MuhammadIsmail0331/mclaren-6wd-sumobot/cad/rev-d-workshop/README.md

# Rev D workshop fit prototype

This is the preserved workshop revision. The 180-instance SolidWorks 2025 assembly shows six adapted holders and retains the 12 earlier saddle/cap instances hidden. It contains the wider motor rail returns and was tested by rebuilding a copy extracted into a separate folder.

- [Workshop handoff](START%20HERE.md)
- [Hardware and fit checks](Hardware%20to%20buy.md)
- [Native verification](Native%20verification.json)
- [SolidWorks files](SolidWorks)
- [Print-first files](Print%20-%20first%20fit%20only)
- [Pilot laser profiles](Laser%20-%20pilot%20files)

The pilot profiles support a first build trial. Confirm the gearbox and tire fit and shop forming and joining before cutting a complete chassis. The lower-cost club build is tracked separately.
