MuhammadIsmail0331/mclaren-6wd-sumobot/cad/rev-c/Views/02 Gearmotor face rail.png

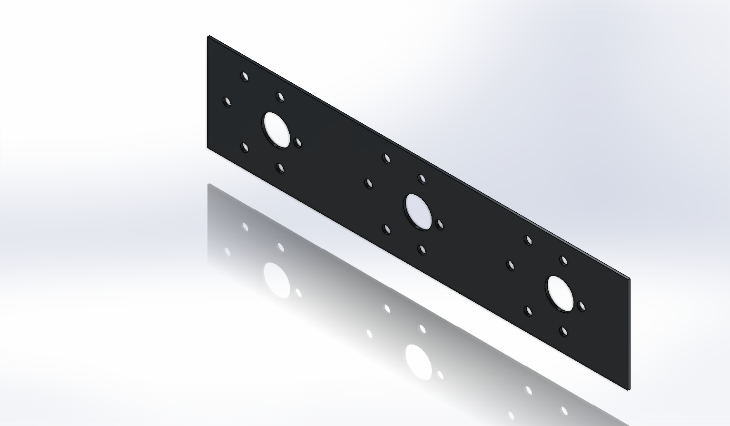
cad/rev-c/Views/02 Gearmotor face rail.png
