MuhammadIsmail0331/mclaren-6wd-sumobot/cad/rev-c/Views/04 PETG motor clamp saddle.png

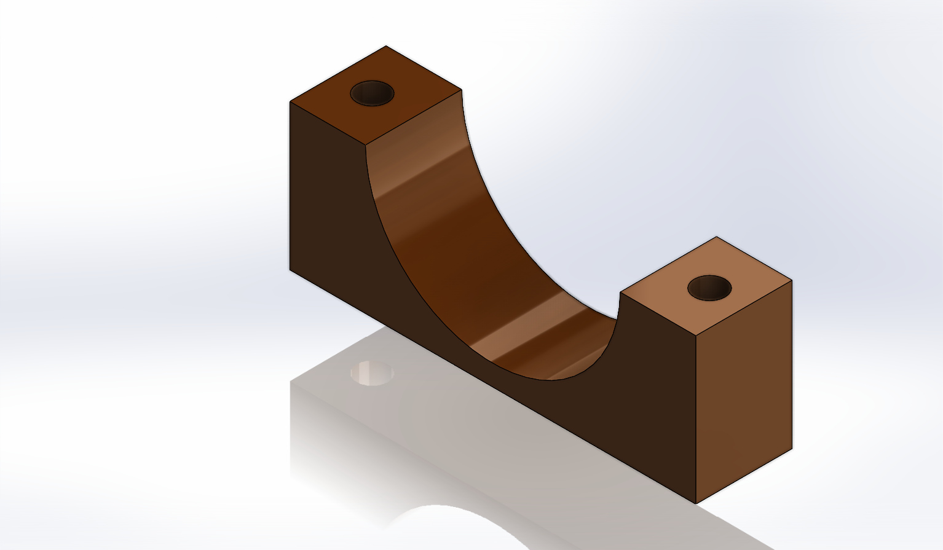
cad/rev-c/Views/04 PETG motor clamp saddle.png
