MuhammadIsmail0331/mclaren-6wd-sumobot/cad/rev-c/Views/05 PETG motor clamp cap.png

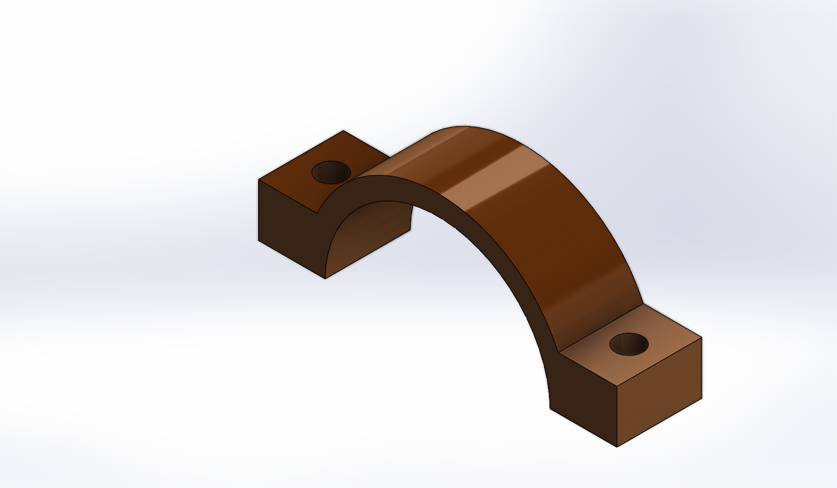
cad/rev-c/Views/05 PETG motor clamp cap.png
