MuhammadIsmail0331/mclaren-6wd-sumobot/cad/rev-c/Views/12 Insulated pack tray.png

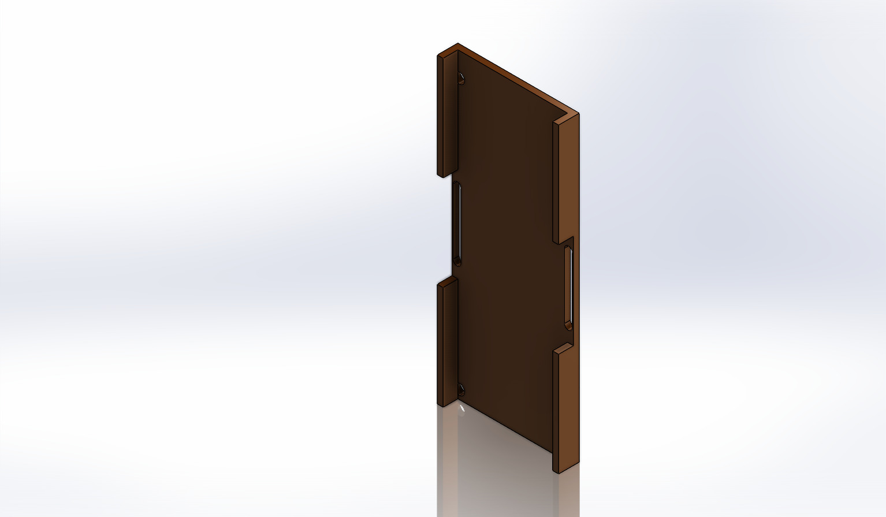
cad/rev-c/Views/12 Insulated pack tray.png
