MuhammadIsmail0331/mclaren-6wd-sumobot/cad/rev-c/Views/15 Electronics deck.png

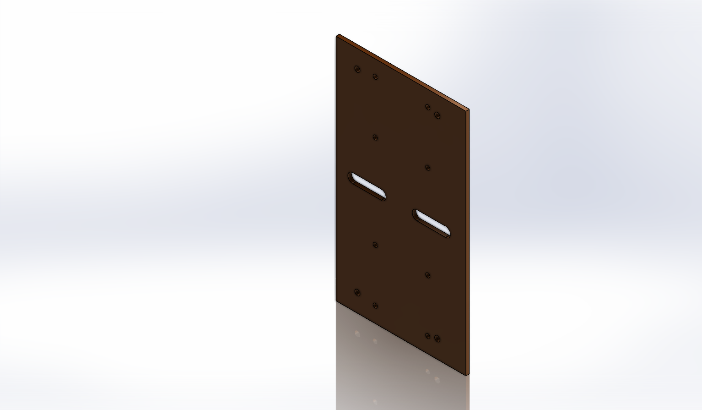
cad/rev-c/Views/15 Electronics deck.png
