MuhammadIsmail0331/mclaren-6wd-sumobot/cad/rev-c/Views/18 Electronics side riser.png

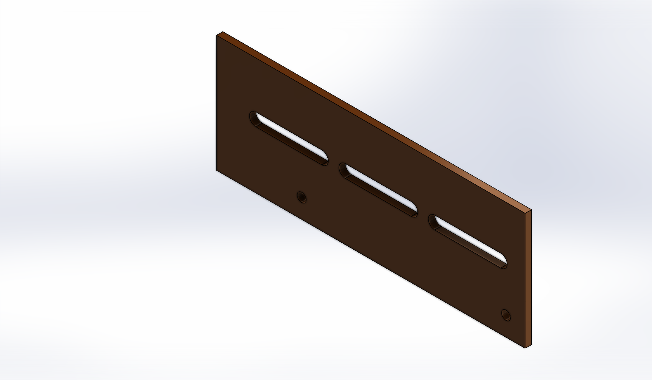
cad/rev-c/Views/18 Electronics side riser.png
