MuhammadIsmail0331/mclaren-6wd-sumobot/cad/rev-c/Views/23 Gearbox face doubler.png

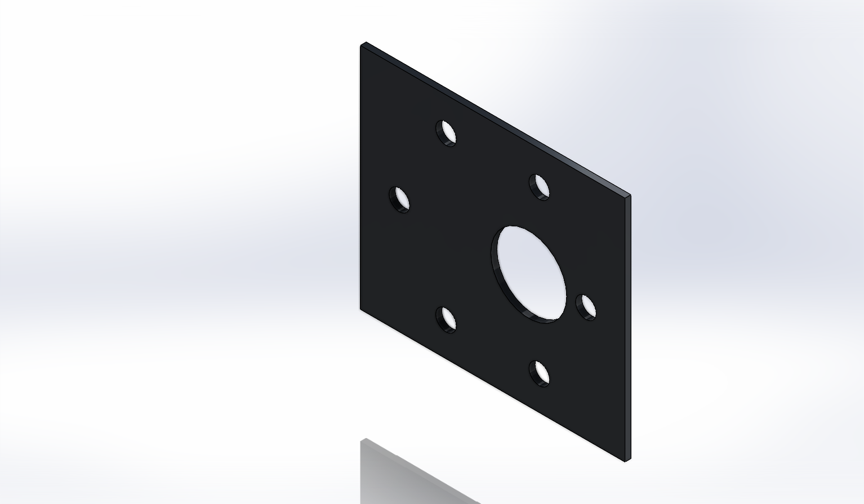
cad/rev-c/Views/23 Gearbox face doubler.png
