MuhammadIsmail0331/mclaren-6wd-sumobot/cad/rev-c/Views/REF Team JGB37 motor.png

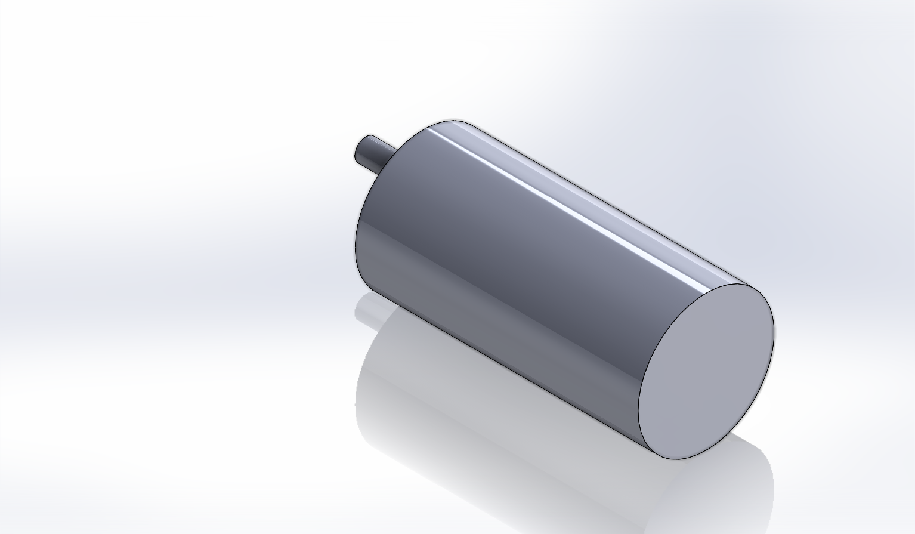
cad/rev-c/Views/REF Team JGB37 motor.png
