MuhammadIsmail0331/mclaren-6wd-sumobot/cad/rev-c/Views/RevC CAD 02 Plan.png

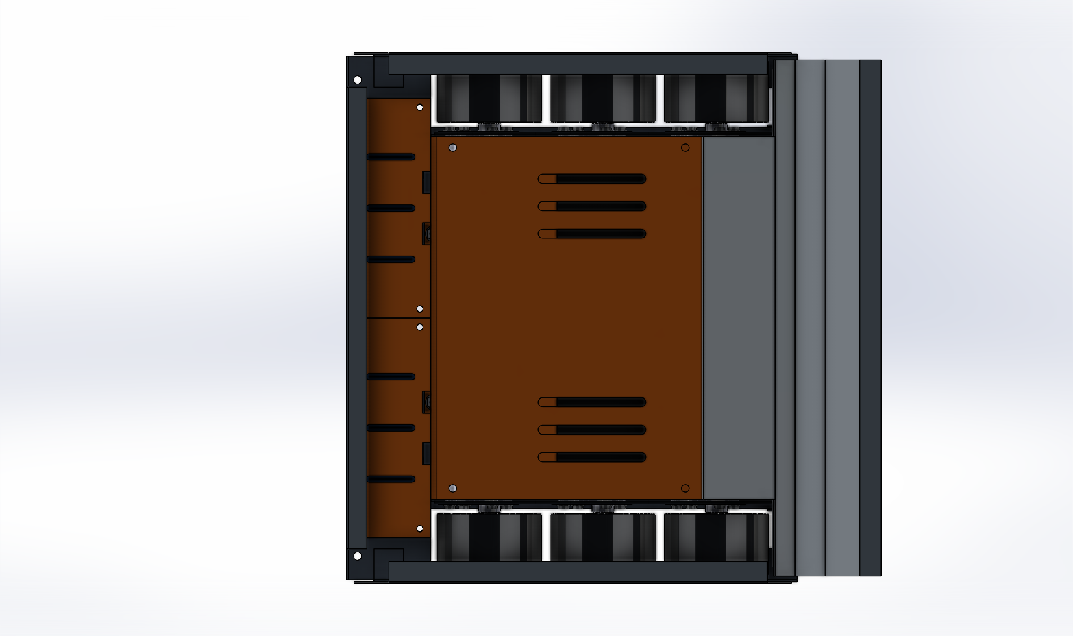
cad/rev-c/Views/RevC CAD 02 Plan.png
