MuhammadIsmail0331/mclaren-6wd-sumobot/cad/rev-c/Views/RevC CAD 03 Side.png

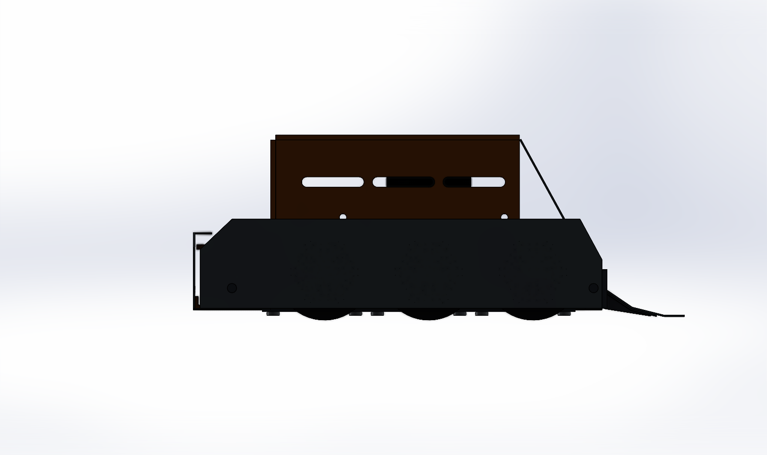
cad/rev-c/Views/RevC CAD 03 Side.png
