MuhammadIsmail0331/mclaren-6wd-sumobot/cad/rev-c/Views/RevC CAD 04 Front.png

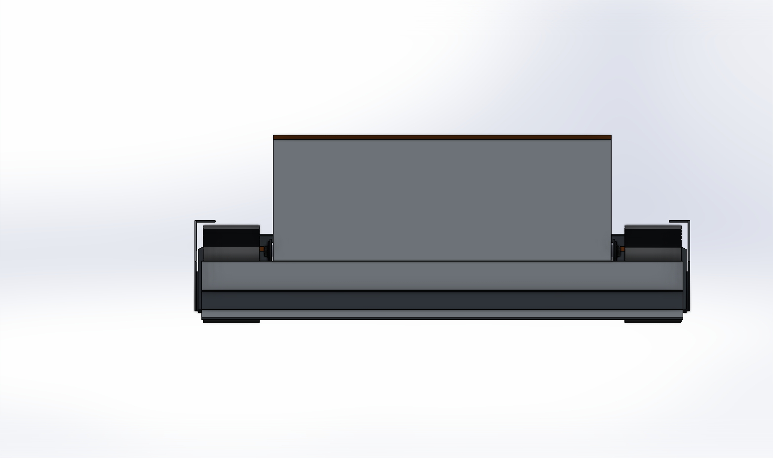
cad/rev-c/Views/RevC CAD 04 Front.png
