MuhammadIsmail0331/mclaren-6wd-sumobot/cad/rev-c/Views/RevC CAD 05 Service access.png

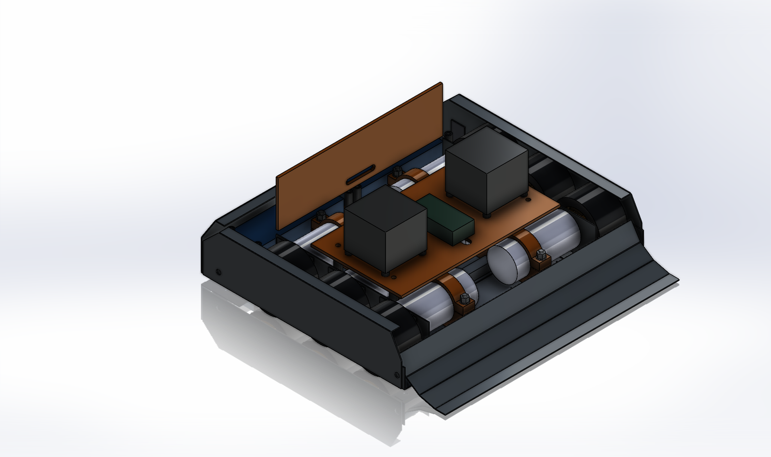
cad/rev-c/Views/RevC CAD 05 Service access.png
