MuhammadIsmail0331/mclaren-6wd-sumobot/cad/rev-c/Views/RevC CAD 06 Drivetrain and packs.png

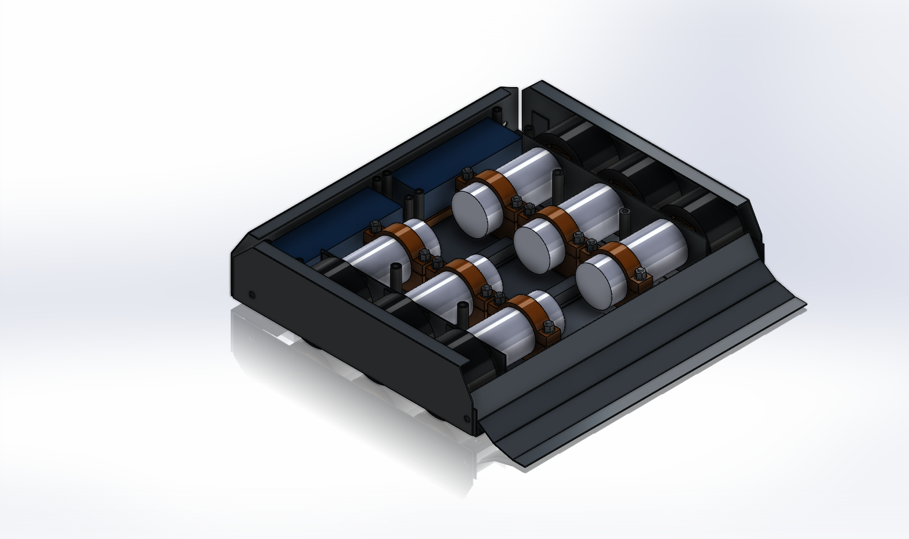
cad/rev-c/Views/RevC CAD 06 Drivetrain and packs.png
