MuhammadIsmail0331/mclaren-6wd-sumobot/cad/rev-c/Views/RevC CAD 07 Motor mounting bank.png

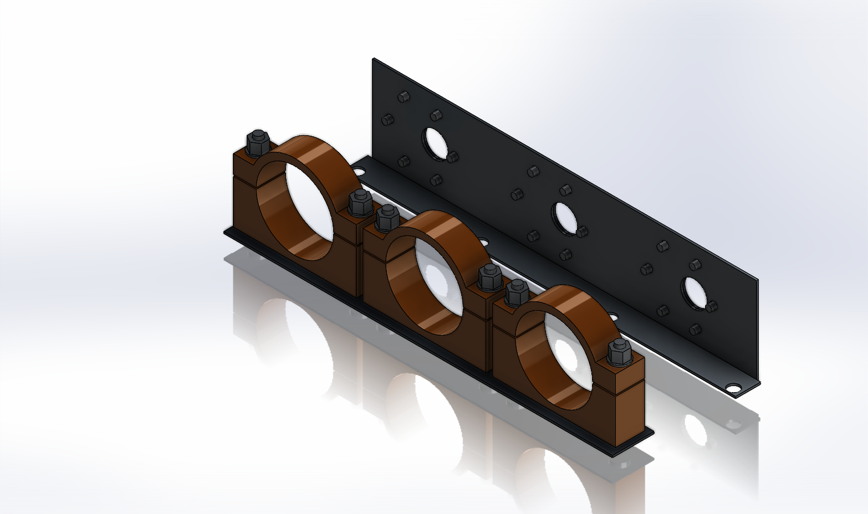
cad/rev-c/Views/RevC CAD 07 Motor mounting bank.png
