MuhammadIsmail0331/mclaren-6wd-sumobot/cad/rev-a/Parts list.md

# McLaren 6WD Rev A parts list

| Native part | Quantity | Material or fit status |
|---|---:|---|
| 01 Base plate | 1 | 2 mm low-carbon steel, laser cut |
| 02 Gearmotor face rail | 2 | 3 mm low-carbon steel, transfer drill gearbox screws |
| 03 Motor rail weld-on flange | 2 | 3 mm low-carbon steel, weld to rail then bolt to floor |
| 04 Rear motor cradle | 6 | PETG saddle plus thin compliant anti-slip strip, under body only |
| 05 Motor keeper strap envelope | 6 | Cushioned metal band with feet. Detail after motor fit. |
| 06 Formed three-bend scoop | 1 | 1.5 mm low-carbon steel, 2 mm provisional inside radius |
| 07 Scoop support rib | 3 | 3 mm low-carbon steel, profile cut |
| 08 Scoop support foot | 3 | 3 mm steel, weld under each rib |
| 09 Wheel side guard | 2 | 2 mm low-carbon steel, removable |
| 10 Guard angle | 4 | 2 mm steel, welded L or press-brake angle |
| 11 Rear bumper wall | 1 | 2 mm low-carbon steel |
| 12 Insulated pack tray | 2 | PETG, 41 x 108 mm print; add compliant liner and strap |
| 13 Pack access panel | 2 | PETG, removable insulated cover |
| 14 Pack panel spacer | 8 | Nylon or PETG prototype spacer |
| 15 Electronics deck | 1 | PETG, insulated removable deck, 109 x 196 mm |
| 16 Deck spacer | 4 | Insulated M4 spacer, sleeve or standoff |
| 17 PCB insulating standoff | 8 | Nylon, location subject to PCB hole measurement |
| 18 Electronics side riser | 2 | PETG, behind tire envelope |
| 19 Front upper closure | 1 | 2 mm low-carbon steel, or bendable abrasion-resistant polymer |
| 20 Electronics lid | 1 | PETG, 145 x 198 mm, vented and removable |
| 21 Electronics rear closure | 1 | PETG, center cable pass |
| 22 Silicone tread envelope | 6 | Cast silicone, 57 OD x 33 mm. Actual casting fills around rim. |
| REF ESP32 plus buck space | 1 | Provisional 54 x 26 x 15 mm logic space |
| REF LiPo 3S pack envelope | 2 | Provisional 35 x 100 x 27 mm. Confirm each pack and lead exit. |
| REF Team IBT-2 | 2 | Team October module envelope. Verify mounting and terminal access. |
| REF Team JGB37 motor | 6 | Team October motor envelope. Verify screw pattern and wire/terminal reach. |
| REF Team rim 0.22 | 6 | Team November rim STEP. Verify shaft fit with a sample casting. |

Total modeled instances **84**. Add measured fasteners, pack straps, compliant liners, wiring, protection and disconnect hardware for fabrication.
