MuhammadIsmail0331/mclaren-6wd-sumobot/cad/rev-c/Mount laser DXF/03 Motor rail return strip.dxf

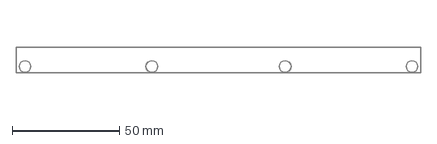
[picture p17: CAD file, 2026-11-09]
cad/rev-c/Mount laser DXF/03 Motor rail return strip.dxf
188.0 x 12.0 mm
