MuhammadIsmail0331/mclaren-6wd-sumobot/cad/rev-c/Mount STEP/23 Gearbox face doubler.STEP

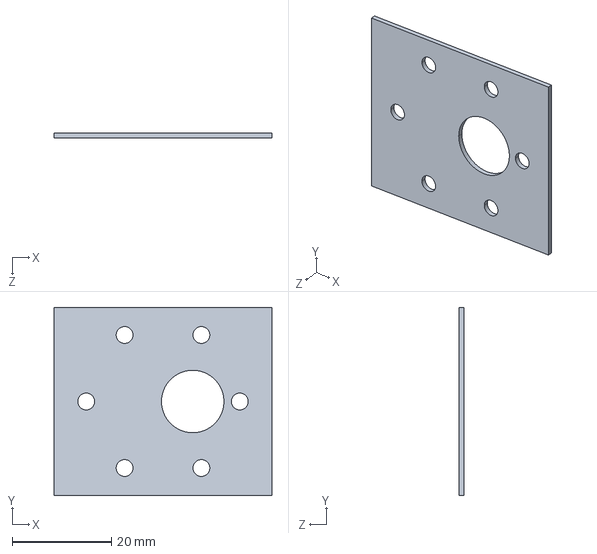
[picture p18: CAD file, 2026-11-09]
cad/rev-c/Mount STEP/23 Gearbox face doubler.STEP
44.0 x 38.0 x 1.00 mm
