MuhammadIsmail0331/mclaren-6wd-sumobot/cad/rev-c/Reference STEP/Motors.STEP

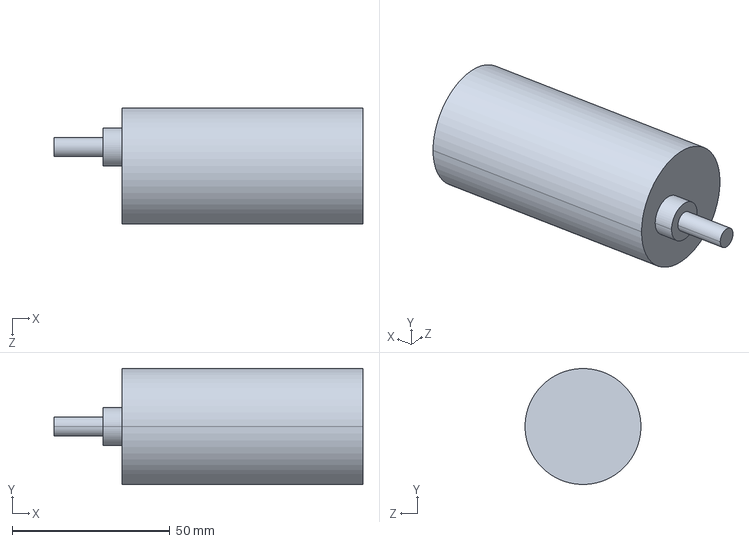
[picture p19: CAD file, 2026-11-06]
cad/rev-c/Reference STEP/Motors.STEP
98.0 x 36.8 x 36.8 mm
