MuhammadIsmail0331/mclaren-6wd-sumobot/cad/rev-d-workshop/Laser - pilot files/23 Gearbox face doubler - transfer drill.dxf

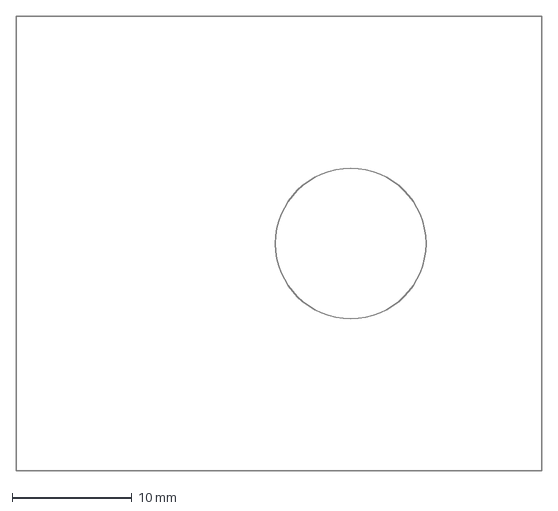
[picture p20: CAD file, 2026-11-09]
cad/rev-d-workshop/Laser - pilot files/23 Gearbox face doubler - transfer drill.dxf
44.0 x 38.0 mm
