MuhammadIsmail0331/mclaren-6wd-sumobot/cad/rev-d-workshop/McLaren 6WD - Rev D fit.STEP

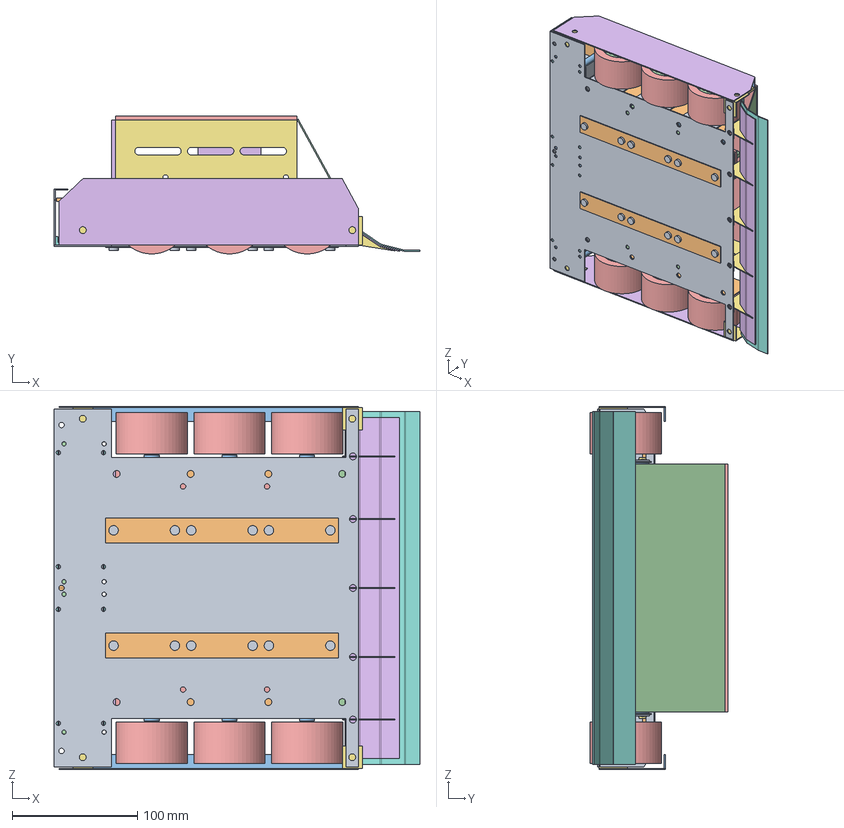
[picture p21: CAD file, 2026-11-09]
cad/rev-d-workshop/McLaren 6WD - Rev D fit.STEP
292.0 x 110.0 x 290.0 mm
01 Base plate
02 Gearmotor face rail x 2
REF Team JGB37 motor x 6
REF Team rim 0.22 x 6
22 Silicone tread envelope x 6
09 Wheel side guard x 2
10 Guard angle x 4
12 Insulated pack tray x 2
REF LiPo 3S pack envelope x 2
13 Pack access panel x 2
14 Purchased M3 pack-cover spacer x 8
16 Purchased M4 deck spacer x 4
17 Purchased M3 PCB spacer x 8
REF Team IBT-2 x 2
18 Electronics side riser x 2
06 Three-bend scoop skin
11 Rear bumper wall
15 Electronics deck
REF ESP32 plus buck space
19 Front upper closure
20 Electronics lid
21 Electronics rear closure
07 Scoop support rib x 5
08 Scoop support foot x 5
23 Gearbox face doubler x 6
24 Clamp backing strip x 2
27 Side guard inboard return x 2
28 Rear bumper return
25 Floor hat stiffener x 2
26 Scoop formed underlay
29 REF M3x5 face screw and washer x 36
03 Wide motor rail return x 2
33 REF M4x20 low-head floor bolt x 12
31 REF M4 washer and locknut - floor x 12
34 REF M4x20 jaw bolt and 2 mm spacer x 6
35 REF M4 narrow washer and locknut x 6
32 Shaheer V2 holder - chassis fit x 6
