MuhammadIsmail0331/mclaren-6wd-sumobot/cad/rev-d-workshop/Print - after fit/18 Electronics side riser.STL

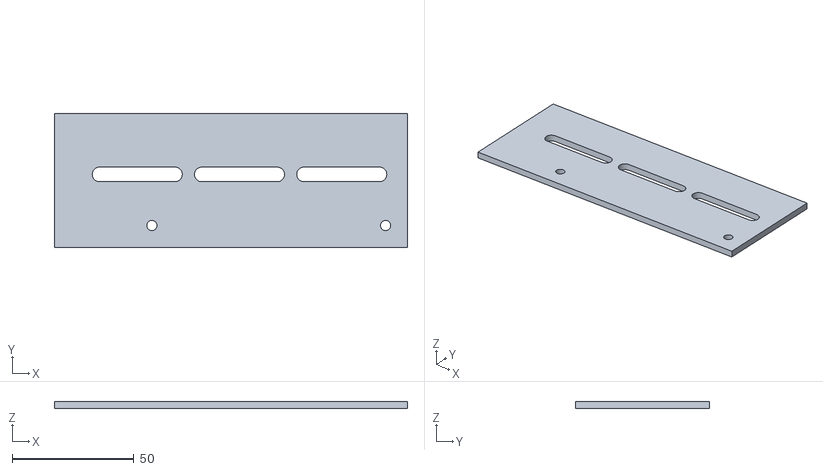
[picture p22: CAD file, 2026-11-09]
cad/rev-d-workshop/Print - after fit/18 Electronics side riser.STL
145.0 x 55.0 x 3.00
