MuhammadIsmail0331/mclaren-6wd-sumobot/cad/rev-d-workshop/Print - first fit only/01 PRINT ONE - 32 Shaheer V2 holder - chassis fit.stl

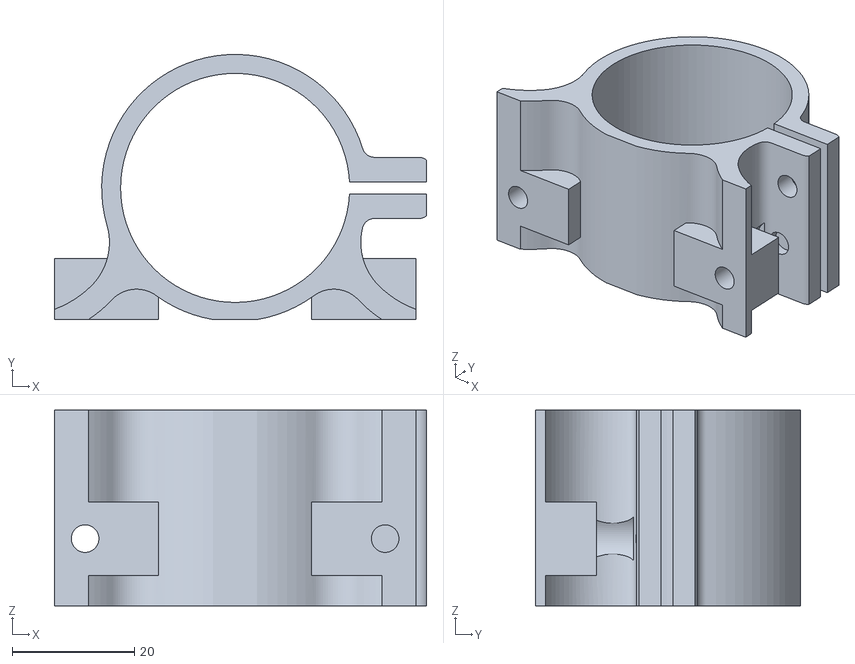
[picture p23: CAD file, 2026-11-09]
cad/rev-d-workshop/Print - first fit only/01 PRINT ONE - 32 Shaheer V2 holder - chassis fit.stl
60.8 x 43.3 x 32.0
