MuhammadIsmail0331/mclaren-6wd-sumobot/cad/rev-c/Mount laser DXF/02 Gearmotor face rail.dxf

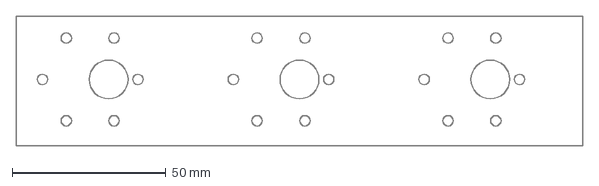
[picture p24: CAD file, 2026-11-09]
cad/rev-c/Mount laser DXF/02 Gearmotor face rail.dxf
184.0 x 42.0 mm
