MuhammadIsmail0331/mclaren-6wd-sumobot/cad/rev-c/Reference STEP/wheels sumo 0.22 tol.step

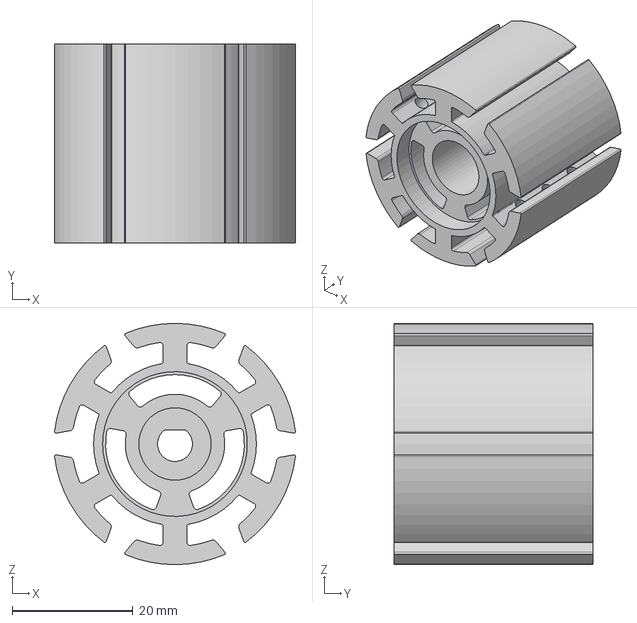
[picture p25: CAD file, 2026-11-06]
cad/rev-c/Reference STEP/wheels sumo 0.22 tol.step
40.0 x 33.0 x 40.0 mm
