MuhammadIsmail0331/mclaren-6wd-sumobot/cad/rev-d-workshop/Laser - pilot files/02 Gearmotor face rail - transfer drill.dxf

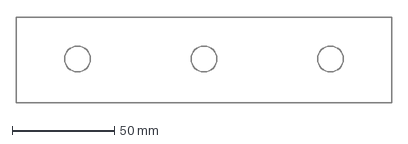
[picture p26: CAD file, 2026-11-09]
cad/rev-d-workshop/Laser - pilot files/02 Gearmotor face rail - transfer drill.dxf
184.0 x 42.0 mm
