MuhammadIsmail0331/mclaren-6wd-sumobot/cad/rev-d-workshop/Print - after fit/13 Pack access panel.STL

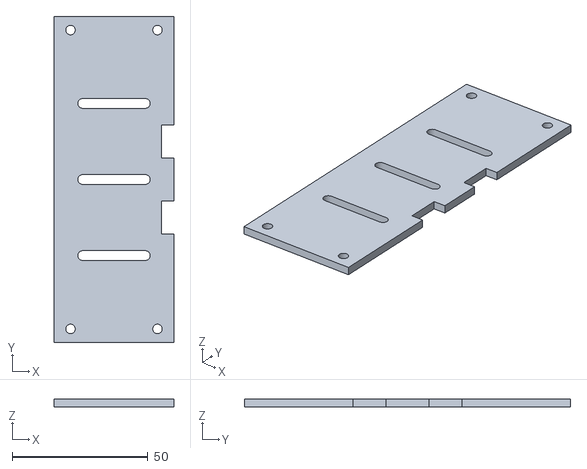
[picture p27: CAD file, 2026-11-09]
cad/rev-d-workshop/Print - after fit/13 Pack access panel.STL
44.0 x 120.0 x 2.80
