MuhammadIsmail0331/mclaren-6wd-sumobot/cad/rev-d-workshop/Print - first fit only/02 GAUGE BATTERY FIRST - 12 Insulated pack tray.STL

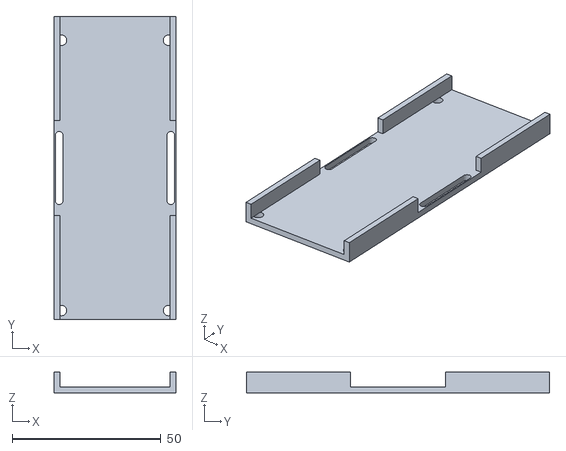
[picture p28: CAD file, 2026-11-09]
cad/rev-d-workshop/Print - first fit only/02 GAUGE BATTERY FIRST - 12 Insulated pack tray.STL
41.0 x 102.0 x 7.00
