MuhammadIsmail0331/mclaren-6wd-sumobot/cad/rev-d-workshop/SolidWorks/14 Purchased M3 pack-cover spacer.SLDPRT

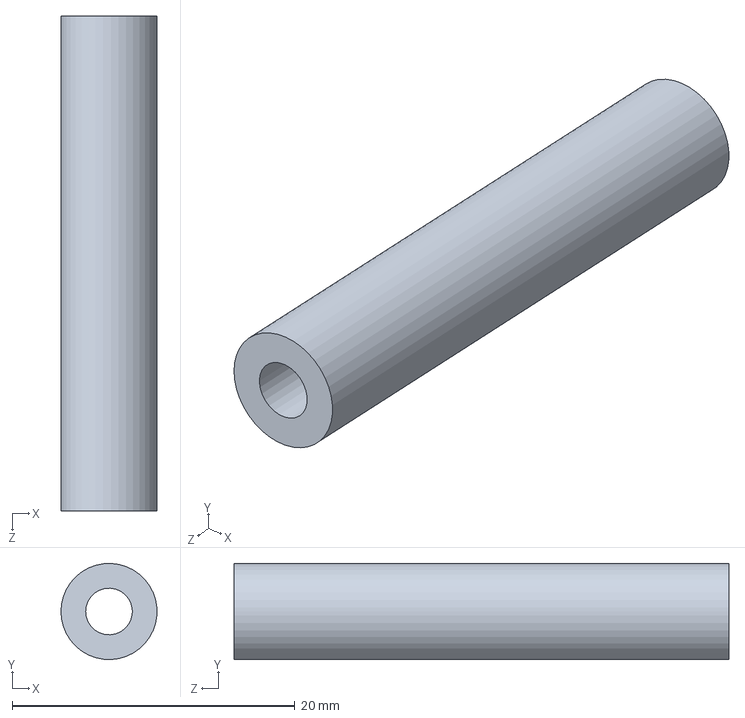
[picture p29: CAD file, 2026-11-09]
cad/rev-d-workshop/SolidWorks/14 Purchased M3 pack-cover spacer.SLDPRT
6.80 x 6.79 x 35.0 mm
