MuhammadIsmail0331/mclaren-6wd-sumobot/cad/rev-c/03 Motor rail return strip.SLDPRT

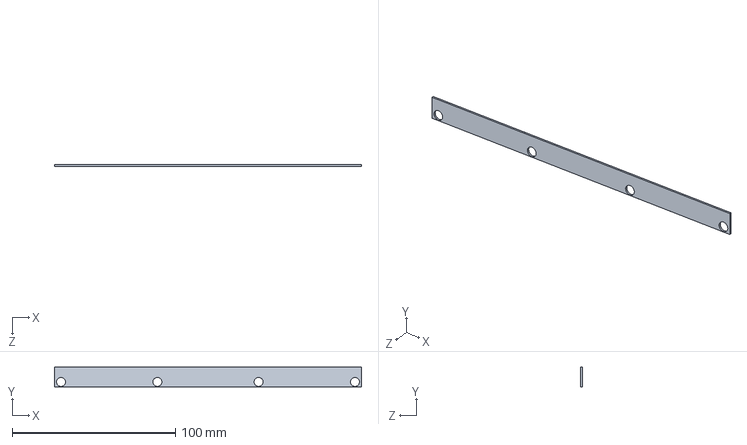
[picture p30: CAD file, 2026-11-09]
cad/rev-c/03 Motor rail return strip.SLDPRT
188.0 x 12.0 x 1.00 mm
