MuhammadIsmail0331/mclaren-6wd-sumobot/cad/rev-c/Mount laser DXF/23 Gearbox face doubler.dxf

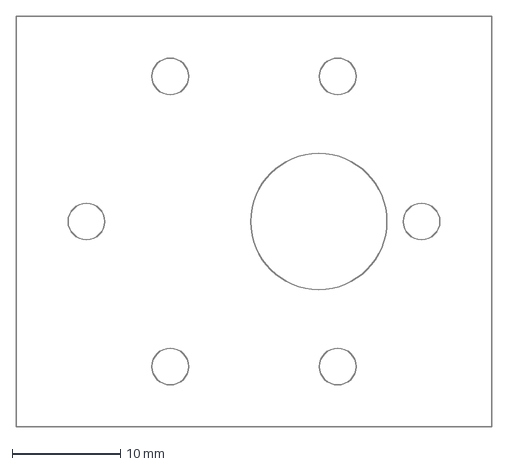
[picture p31: CAD file, 2026-11-09]
cad/rev-c/Mount laser DXF/23 Gearbox face doubler.dxf
44.0 x 38.0 mm
