MuhammadIsmail0331/mclaren-6wd-sumobot/cad/rev-c/Reference STEP/Motor Driver.STEP

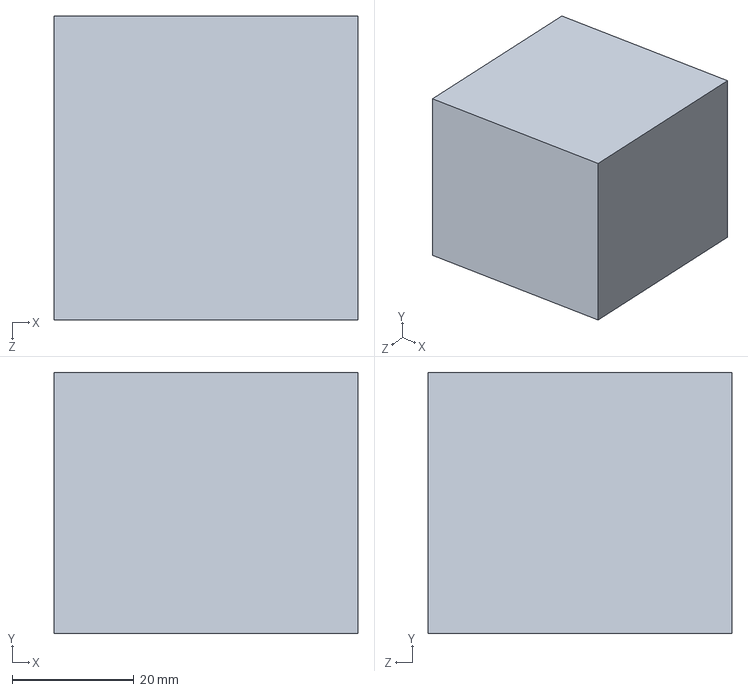
[picture p32: CAD file, 2026-11-06]
cad/rev-c/Reference STEP/Motor Driver.STEP
50.0 x 43.0 x 50.0 mm
