MuhammadIsmail0331/mclaren-6wd-sumobot/cad/rev-d-workshop/Laser - pilot files/03 Wide motor rail return - shop review.dxf

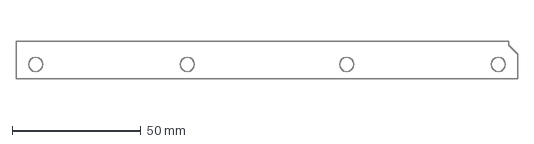
[picture p33: CAD file, 2026-11-09]
cad/rev-d-workshop/Laser - pilot files/03 Wide motor rail return - shop review.dxf
195.0 x 14.5 mm
