MuhammadIsmail0331/mclaren-6wd-sumobot/cad/rev-d-workshop/Print - first fit only/03 GAUGE BOARDS FIRST - 15 Electronics deck.STL

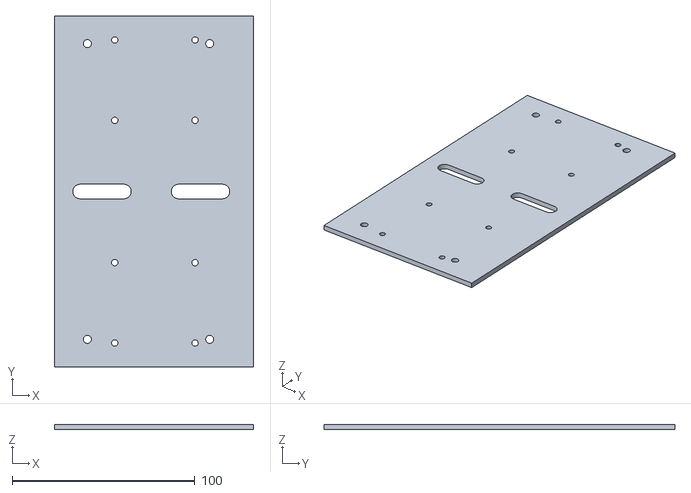
[picture p34: CAD file, 2026-11-09]
cad/rev-d-workshop/Print - first fit only/03 GAUGE BOARDS FIRST - 15 Electronics deck.STL
109.0 x 192.0 x 3.00
