MuhammadIsmail0331/mclaren-6wd-sumobot/cad/rev-d-workshop/SolidWorks/17 Purchased M3 PCB spacer.SLDPRT

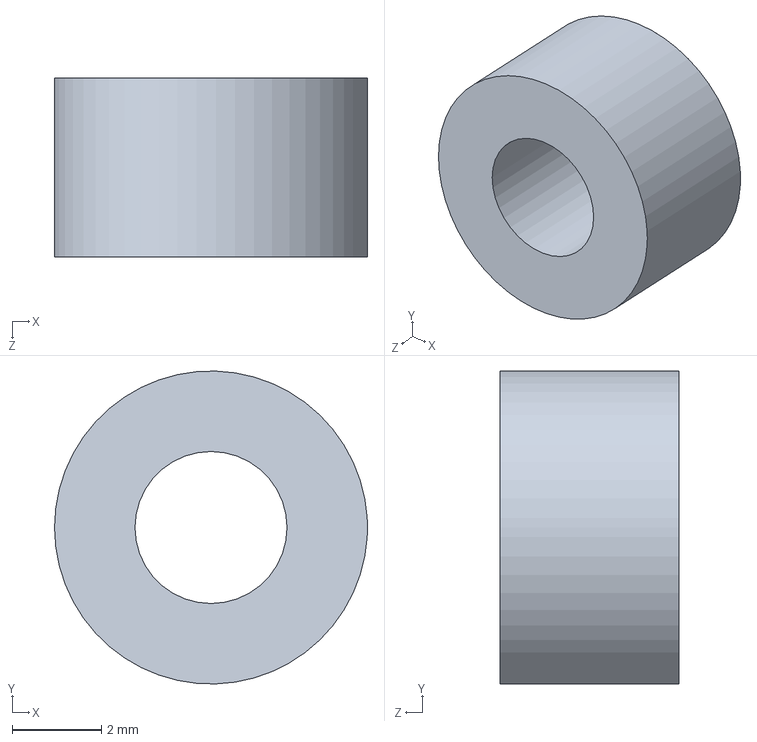
[picture p35: CAD file, 2026-11-09]
cad/rev-d-workshop/SolidWorks/17 Purchased M3 PCB spacer.SLDPRT
7.00 x 7.00 x 4.00 mm
