MuhammadIsmail0331/mclaren-6wd-sumobot/cad/rev-d-workshop/Laser - pilot files/24 Clamp backing strip.dxf

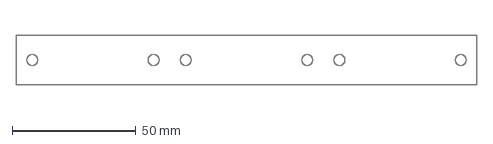
[picture p36: CAD file, 2026-11-09]
cad/rev-d-workshop/Laser - pilot files/24 Clamp backing strip.dxf
186.0 x 20.0 mm
