MuhammadIsmail0331/mclaren-6wd-sumobot/cad/rev-d-workshop/Print - after fit/20 Electronics lid.STL

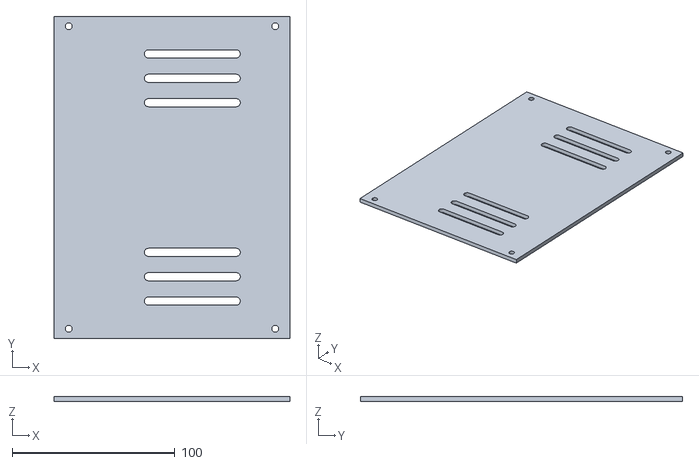
[picture p37: CAD file, 2026-11-09]
cad/rev-d-workshop/Print - after fit/20 Electronics lid.STL
145.0 x 198.0 x 3.00
