MuhammadIsmail0331/mclaren-6wd-sumobot/cad/rev-d-workshop/SolidWorks/27 Side guard inboard return.SLDPRT

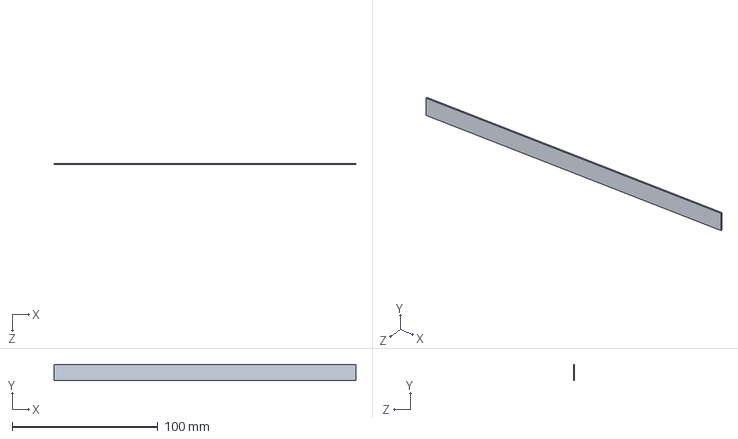
[picture p38: CAD file, 2026-11-09]
cad/rev-d-workshop/SolidWorks/27 Side guard inboard return.SLDPRT
207.0 x 11.0 x 1.00 mm
