MuhammadIsmail0331/mclaren-6wd-sumobot/cad/rev-d-workshop/Laser - pilot files/01 Base plate.dxf

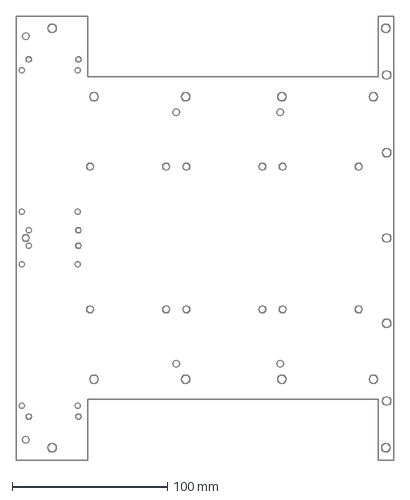
[picture p39: CAD file, 2026-11-09]
cad/rev-d-workshop/Laser - pilot files/01 Base plate.dxf
243.0 x 286.0 mm
