MuhammadIsmail0331/mclaren-6wd-sumobot/cad/rev-d-workshop/SolidWorks/01 Base plate.SLDPRT

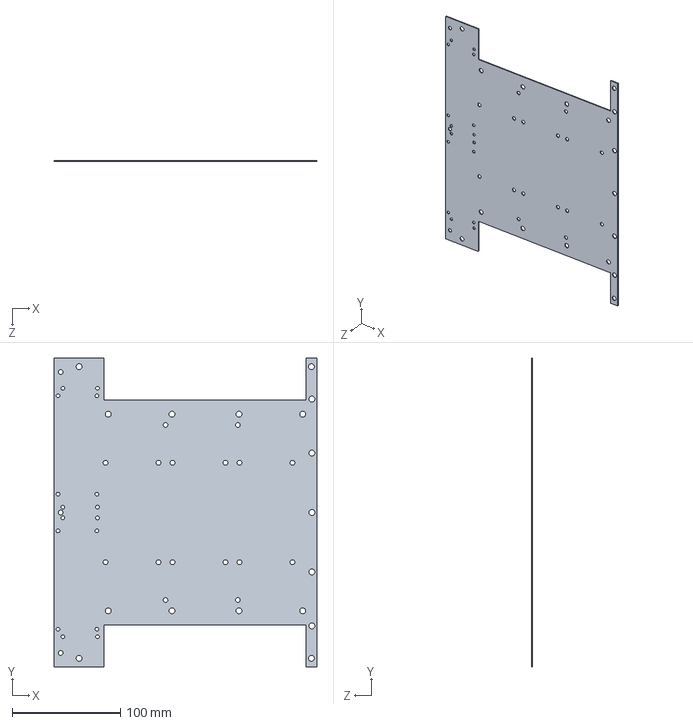
[picture p40: CAD file, 2026-11-09]
cad/rev-d-workshop/SolidWorks/01 Base plate.SLDPRT
243.0 x 286.0 x 1.00 mm
