MuhammadIsmail0331/mclaren-6wd-sumobot/cad/rev-d-workshop/SolidWorks/07 Scoop support rib.SLDPRT

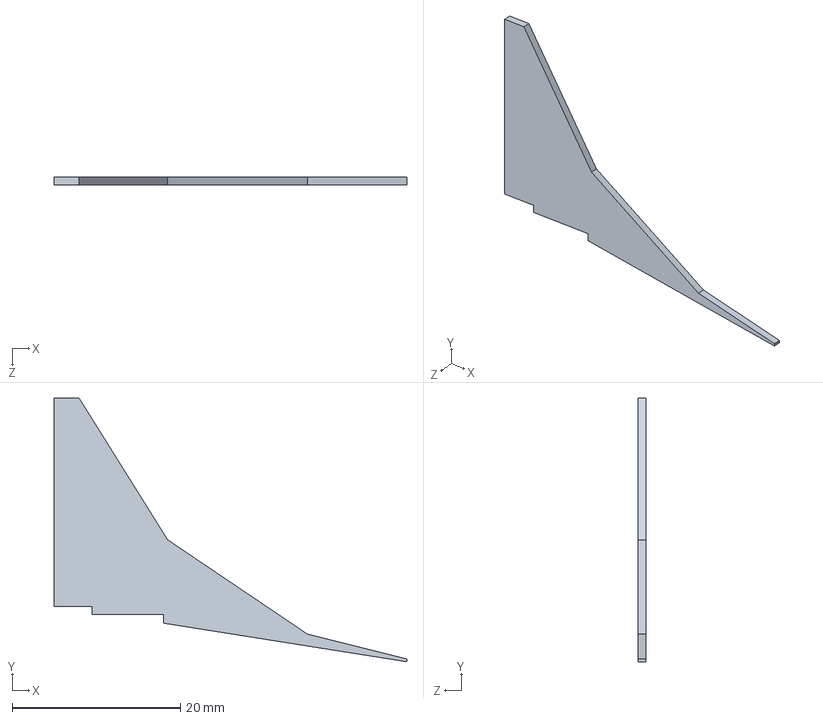
[picture p41: CAD file, 2026-11-09]
cad/rev-d-workshop/SolidWorks/07 Scoop support rib.SLDPRT
42.0 x 31.4 x 1.00 mm
