MuhammadIsmail0331/mclaren-6wd-sumobot/cad/rev-c/Mount STEP/02 Gearmotor face rail.STEP

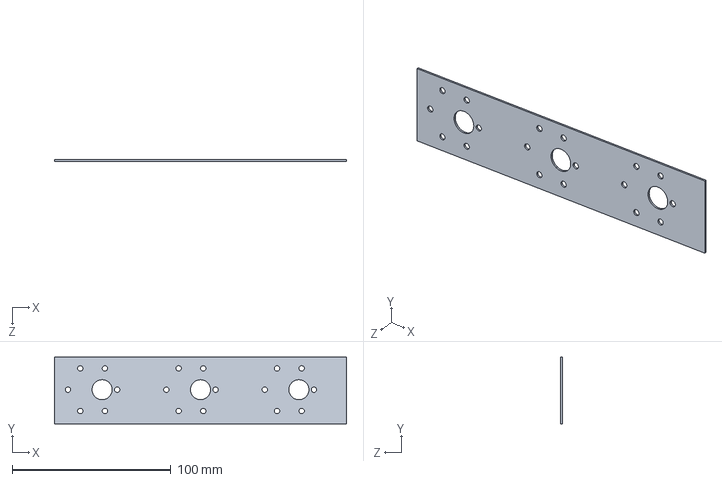
[picture p42: CAD file, 2026-11-09]
cad/rev-c/Mount STEP/02 Gearmotor face rail.STEP
184.0 x 42.0 x 1.00 mm
