MuhammadIsmail0331/mclaren-6wd-sumobot/cad/rev-d-workshop/SolidWorks/03 Wide motor rail return L.SLDPRT

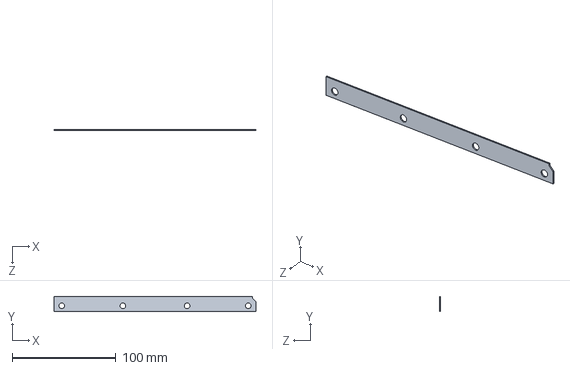
[picture p43: CAD file, 2026-11-09]
cad/rev-d-workshop/SolidWorks/03 Wide motor rail return L.SLDPRT
195.0 x 14.5 x 1.00 mm
