MuhammadIsmail0331/mclaren-6wd-sumobot/cad/rev-c/Mount STEP/04 PETG motor clamp saddle.STEP

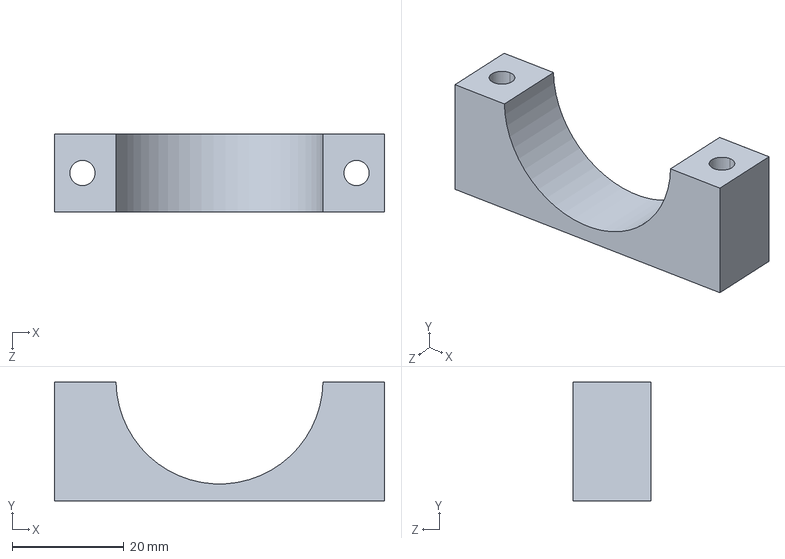
[picture p44: CAD file, 2026-11-09]
cad/rev-c/Mount STEP/04 PETG motor clamp saddle.STEP
59.0 x 21.2 x 14.0 mm
