MuhammadIsmail0331/mclaren-6wd-sumobot/cad/rev-c/Mount STEP/05 PETG motor clamp cap.STEP

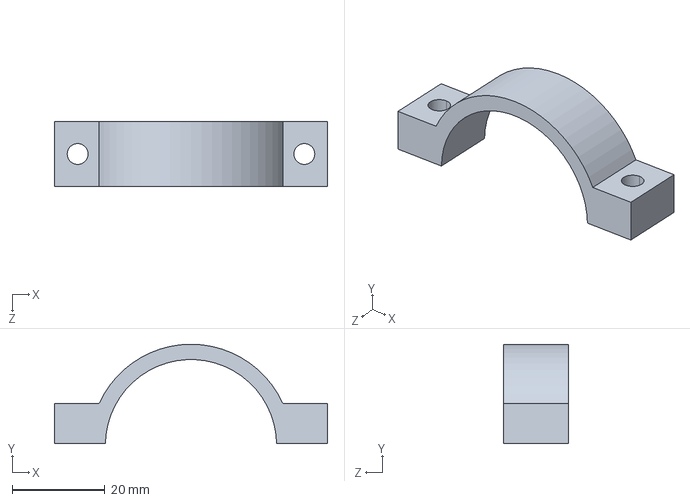
[picture p45: CAD file, 2026-11-09]
cad/rev-c/Mount STEP/05 PETG motor clamp cap.STEP
59.0 x 21.5 x 14.0 mm
