MuhammadIsmail0331/mclaren-6wd-sumobot/cad/rev-d-workshop/SolidWorks/25 Floor hat stiffener.SLDPRT

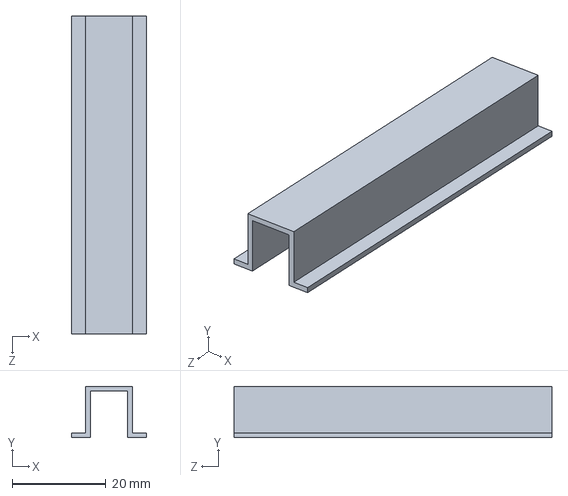
[picture p46: CAD file, 2026-11-09]
cad/rev-d-workshop/SolidWorks/25 Floor hat stiffener.SLDPRT
16.0 x 11.0 x 68.0 mm
