MuhammadIsmail0331/mclaren-6wd-sumobot/cad/rev-d-workshop/SolidWorks/26 Scoop formed underlay.SLDPRT

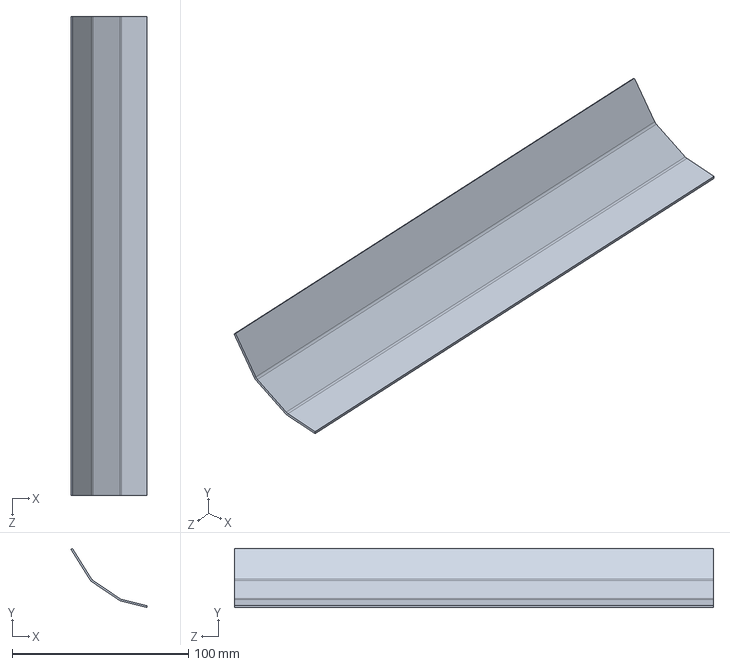
[picture p47: CAD file, 2026-11-09]
cad/rev-d-workshop/SolidWorks/26 Scoop formed underlay.SLDPRT
43.2 x 33.5 x 272.0 mm
