MuhammadIsmail0331/mclaren-6wd-sumobot/cad/rev-d-workshop/SolidWorks/16 Purchased M4 deck spacer.SLDPRT

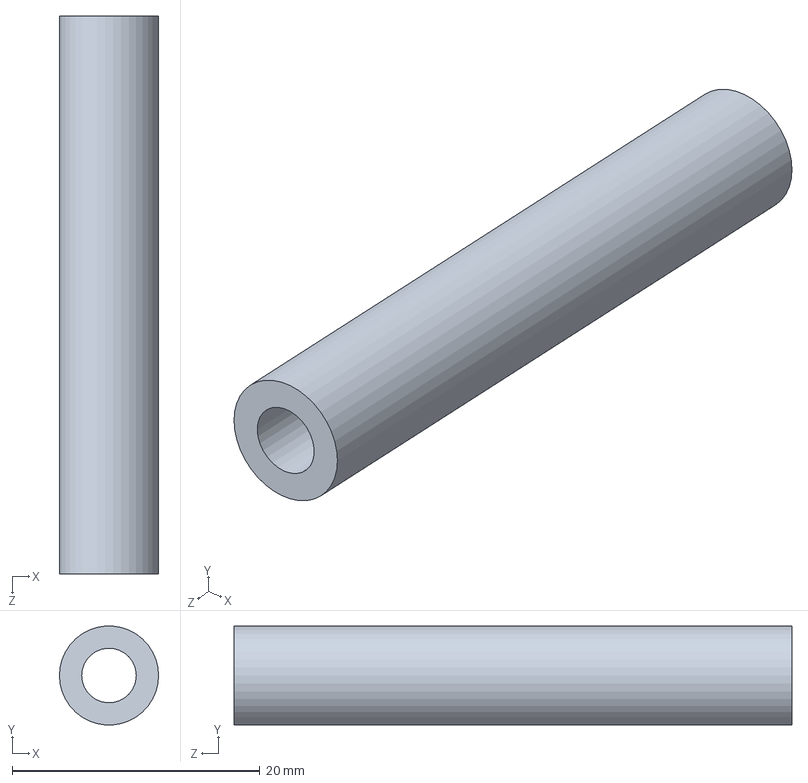
[picture p48: CAD file, 2026-11-09]
cad/rev-d-workshop/SolidWorks/16 Purchased M4 deck spacer.SLDPRT
8.00 x 7.97 x 45.0 mm
