MuhammadIsmail0331/mclaren-6wd-sumobot/cad/rev-d-workshop/SolidWorks/10 Guard angle.SLDPRT

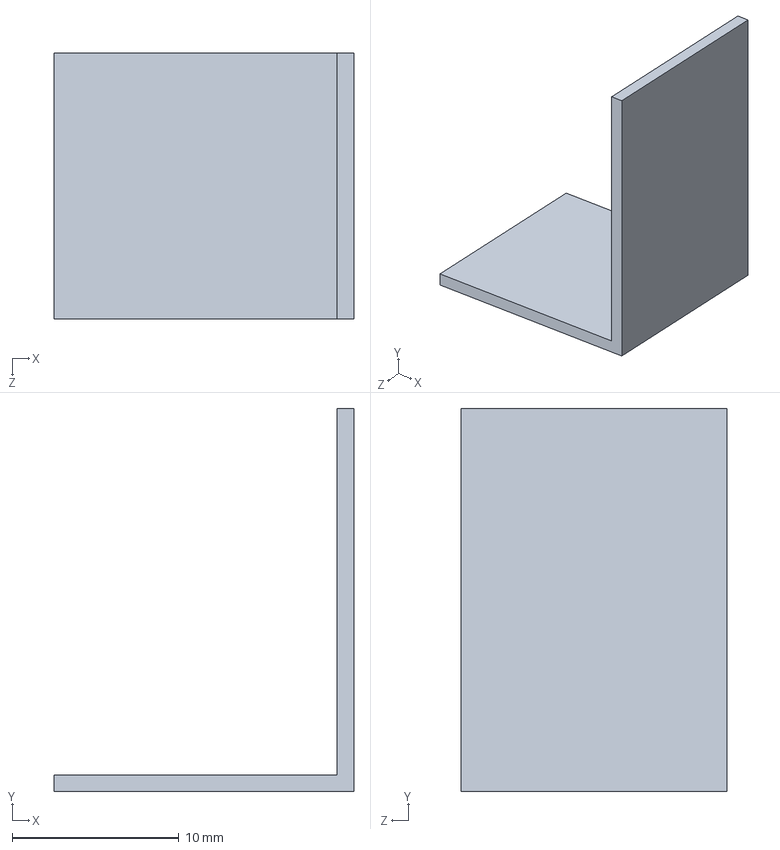
[picture p49: CAD file, 2026-11-09]
cad/rev-d-workshop/SolidWorks/10 Guard angle.SLDPRT
18.0 x 23.0 x 16.0 mm
