MuhammadIsmail0331/mclaren-6wd-sumobot/cad/rev-d-workshop/SolidWorks/28 Rear bumper return.SLDPRT

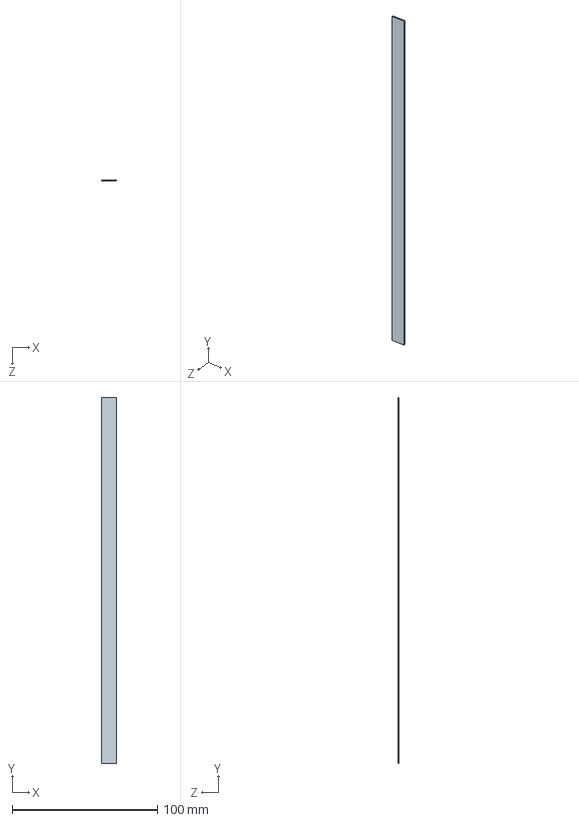
[picture p50: CAD file, 2026-11-09]
cad/rev-d-workshop/SolidWorks/28 Rear bumper return.SLDPRT
10.0 x 252.0 x 1.00 mm
