MuhammadIsmail0331/mclaren-6wd-sumobot/cad/rev-d-workshop/SolidWorks/08 Scoop support foot.SLDPRT

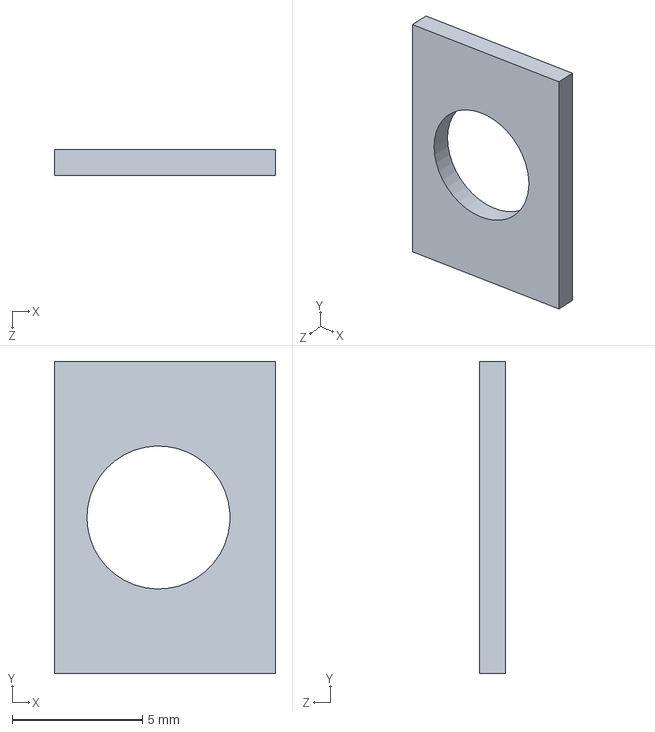
[picture p51: CAD file, 2026-11-09]
cad/rev-d-workshop/SolidWorks/08 Scoop support foot.SLDPRT
8.50 x 12.0 x 1.00 mm
