MuhammadIsmail0331/mclaren-6wd-sumobot/cad/rev-d-workshop/SolidWorks/06 Three-bend scoop skin.SLDPRT

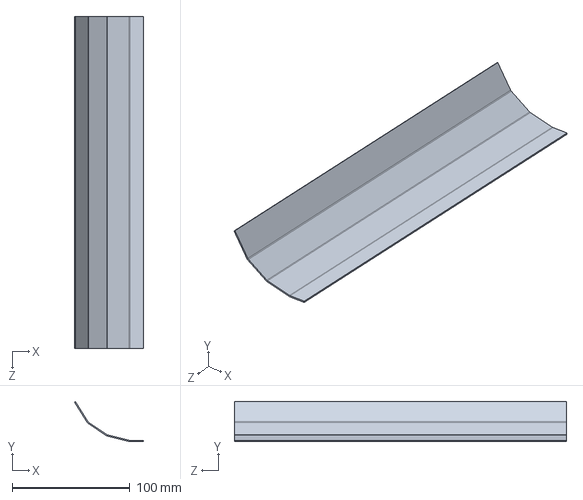
[picture p52: CAD file, 2026-11-09]
cad/rev-d-workshop/SolidWorks/06 Three-bend scoop skin.SLDPRT
58.8 x 34.1 x 282.0 mm
