MuhammadIsmail0331/mclaren-6wd-sumobot/cad/rev-d-workshop/SolidWorks/22 Silicone tread envelope.SLDPRT

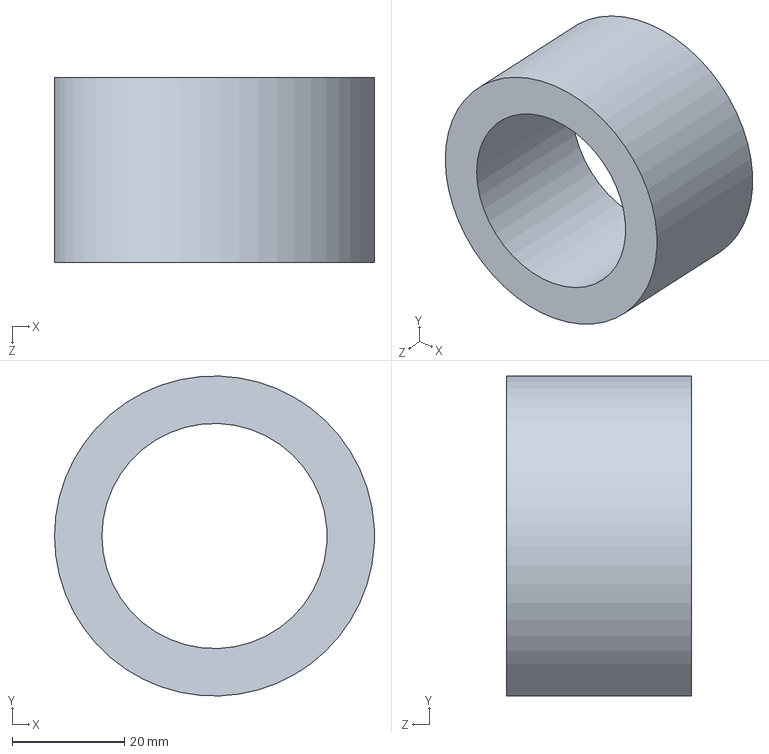
[picture p53: CAD file, 2026-11-09]
cad/rev-d-workshop/SolidWorks/22 Silicone tread envelope.SLDPRT
57.0 x 57.0 x 33.0 mm
