MuhammadIsmail0331/mclaren-6wd-sumobot/cad/rev-d-workshop/SolidWorks/REF ESP32 plus buck space.SLDPRT

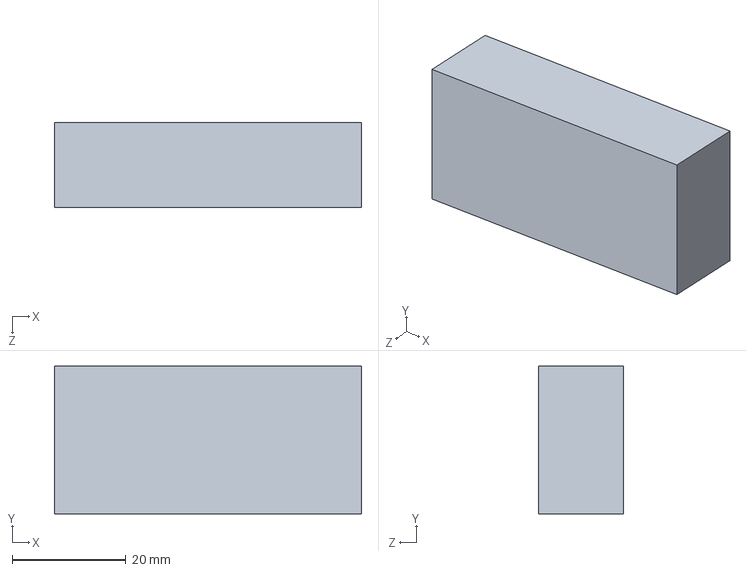
[picture p54: CAD file, 2026-11-09]
cad/rev-d-workshop/SolidWorks/REF ESP32 plus buck space.SLDPRT
54.0 x 26.0 x 15.0 mm
