MuhammadIsmail0331/mclaren-6wd-sumobot/cad/rev-d-workshop/SolidWorks/REF LiPo 3S pack envelope.SLDPRT

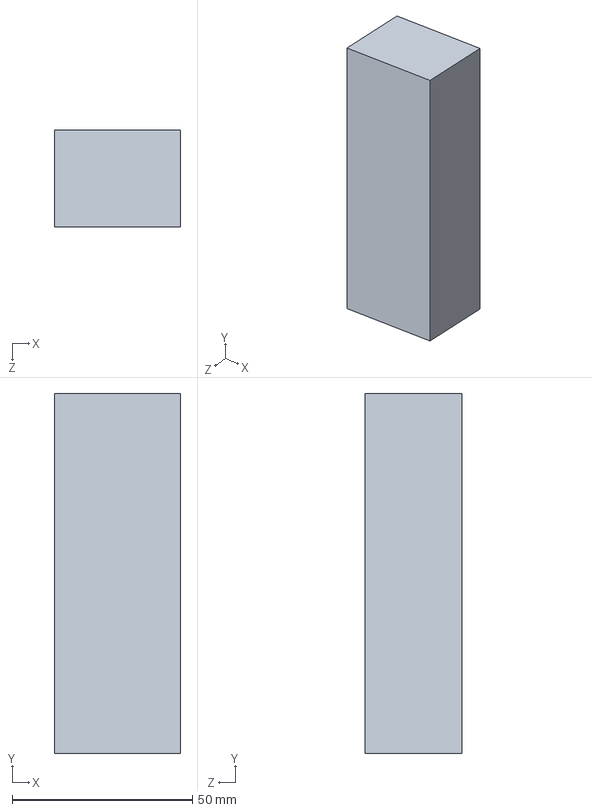
[picture p55: CAD file, 2026-11-09]
cad/rev-d-workshop/SolidWorks/REF LiPo 3S pack envelope.SLDPRT
35.0 x 100.0 x 27.0 mm
