MuhammadIsmail0331/mclaren-6wd-sumobot/cad/rev-d-workshop/SolidWorks/19 Front upper closure.SLDPRT

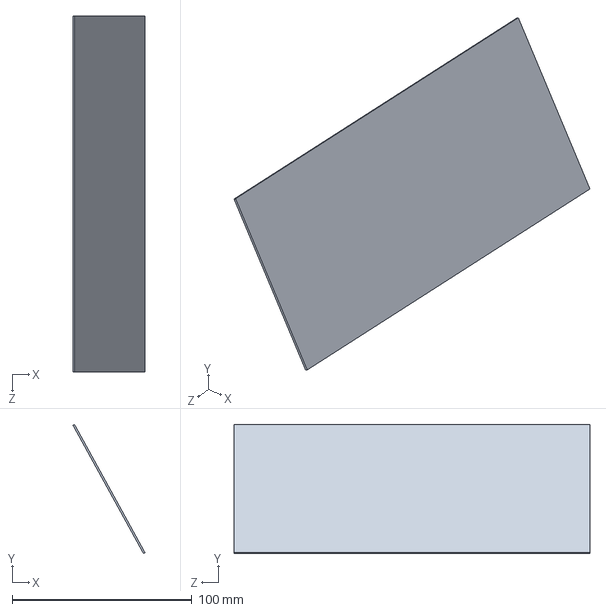
[picture p57: CAD file, 2026-11-09]
cad/rev-d-workshop/SolidWorks/19 Front upper closure.SLDPRT
40.1 x 71.8 x 198.0 mm
