MuhammadIsmail0331/mclaren-6wd-sumobot/cad/rev-d-workshop/SolidWorks/09 Wheel side guard.SLDPRT

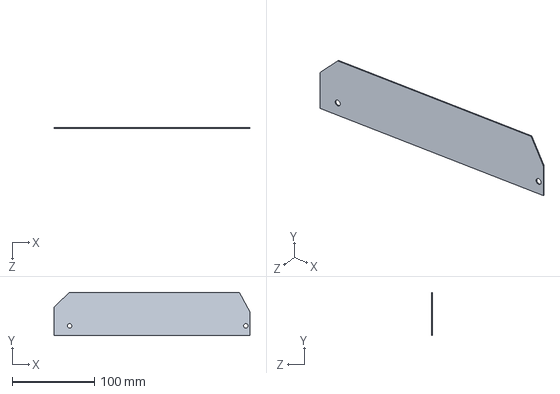
[picture p58: CAD file, 2026-11-09]
cad/rev-d-workshop/SolidWorks/09 Wheel side guard.SLDPRT
239.0 x 53.0 x 1.00 mm
