MuhammadIsmail0331/mclaren-6wd-sumobot/cad/rev-d-workshop/SolidWorks/24 Clamp backing strip.SLDPRT

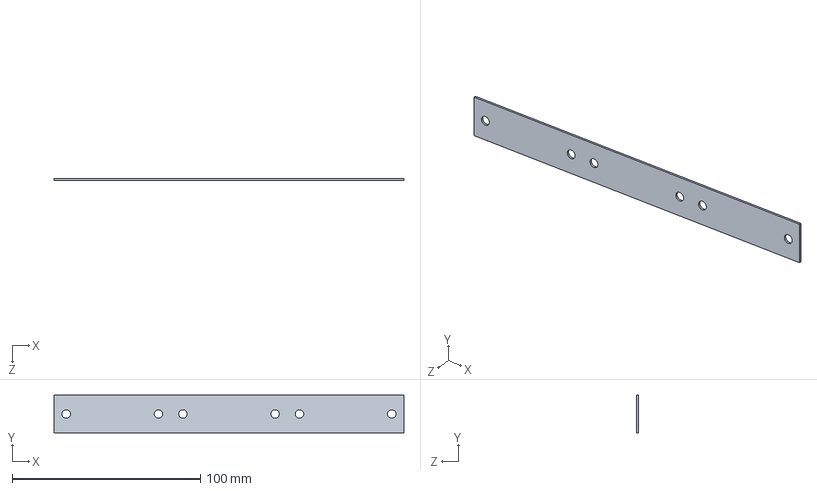
[picture p59: CAD file, 2026-11-09]
cad/rev-d-workshop/SolidWorks/24 Clamp backing strip.SLDPRT
186.0 x 20.0 x 1.00 mm
