MuhammadIsmail0331/mclaren-6wd-sumobot/cad/rev-d-workshop/SolidWorks/11 Rear bumper wall.SLDPRT

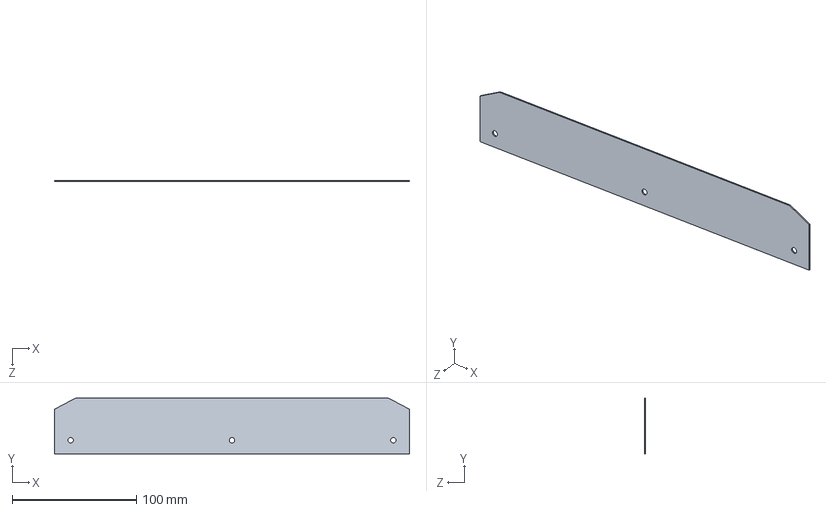
[picture p60: CAD file, 2026-11-09]
cad/rev-d-workshop/SolidWorks/11 Rear bumper wall.SLDPRT
286.0 x 45.0 x 1.00 mm
