MuhammadIsmail0331/mclaren-6wd-sumobot/(list of files, cad)

Other CAD files:
cad/rev-d-workshop/32 Shaheer V2 holder - chassis fit.STEP
cad/rev-c/Mount STEP/18 Electronics side riser.STEP
cad/rev-c/Mount STEP/12 Insulated pack tray.STEP
cad/rev-c/Mount STEP/13 Pack access panel.STEP
cad/rev-c/Mount STEP/20 Electronics lid.STEP
cad/rev-d-workshop/SolidWorks/15 Electronics deck.SLDPRT
cad/rev-c/Mount STEP/15 Electronics deck.STEP
cad/rev-d-workshop/SolidWorks/REF Team JGB37 motor.SLDPRT
cad/rev-d-workshop/SolidWorks/20 Electronics lid.SLDPRT
cad/rev-d-workshop/SolidWorks/REF Team IBT-2.SLDPRT
cad/rev-d-workshop/SolidWorks/18 Electronics side riser.SLDPRT
cad/rev-d-workshop/SolidWorks/12 Insulated pack tray.SLDPRT
cad/rev-d-workshop/SolidWorks/04 PETG motor clamp saddle.SLDPRT
cad/rev-d-workshop/SolidWorks/03 Wide motor rail return R.SLDPRT
cad/rev-d-workshop/SolidWorks/REF Team rim 0.22.SLDPRT
cad/rev-d-workshop/SolidWorks/05 PETG motor clamp cap.SLDPRT
cad/rev-d-workshop/SolidWorks/23 Gearbox face doubler.SLDPRT
cad/rev-d-workshop/SolidWorks/13 Pack access panel.SLDPRT
cad/rev-d-workshop/SolidWorks/02 Gearmotor face rail.SLDPRT
cad/rev-a/01 Base plate.SLDPRT
cad/rev-a/02 Gearmotor face rail.SLDPRT
cad/rev-a/03 Motor rail weld-on flange.SLDPRT
cad/rev-a/04 Rear motor cradle.SLDPRT
cad/rev-a/05 Motor keeper strap envelope.SLDPRT
cad/rev-a/06 Formed three-bend scoop.SLDPRT
cad/rev-a/07 Scoop support rib.SLDPRT
cad/rev-a/08 Scoop support foot.SLDPRT
cad/rev-a/09 Wheel side guard.SLDPRT
cad/rev-a/10 Guard angle.SLDPRT
cad/rev-a/11 Rear bumper wall.SLDPRT
cad/rev-a/12 Insulated pack tray.SLDPRT
cad/rev-a/13 Pack access panel.SLDPRT
cad/rev-a/14 Pack panel spacer.SLDPRT
cad/rev-a/15 Electronics deck.SLDPRT
cad/rev-a/16 Deck spacer.SLDPRT
cad/rev-a/17 PCB insulating standoff.SLDPRT
cad/rev-a/18 Electronics side riser.SLDPRT
cad/rev-a/19 Front upper closure.SLDPRT
cad/rev-a/20 Electronics lid.SLDPRT
cad/rev-a/21 Electronics rear closure.SLDPRT
cad/rev-a/22 Silicone tread envelope.SLDPRT
cad/rev-a/McLaren 6WD - Rev A.SLDASM
cad/rev-a/McLaren 6WD - Rev A.STEP
cad/rev-a/REF ESP32 plus buck space.SLDPRT
cad/rev-a/REF LiPo 3S pack envelope.SLDPRT
cad/rev-a/REF Team IBT-2.SLDPRT
cad/rev-a/REF Team JGB37 motor.SLDPRT
cad/rev-a/REF Team rim 0.22.SLDPRT
cad/rev-b/01 Base plate.SLDPRT
cad/rev-b/02 Gearmotor face rail.SLDPRT
cad/rev-b/03 Motor rail return strip.SLDPRT
cad/rev-b/04 PETG motor clamp saddle.SLDPRT
cad/rev-b/05 PETG motor clamp cap.SLDPRT
cad/rev-b/06 Three-bend scoop skin.SLDPRT
cad/rev-b/07 Scoop support rib.SLDPRT
cad/rev-b/08 Scoop support foot.SLDPRT
cad/rev-b/09 Wheel side guard.SLDPRT
cad/rev-b/10 Guard angle.SLDPRT
cad/rev-b/11 Rear bumper wall.SLDPRT
cad/rev-b/12 Insulated pack tray.SLDPRT
cad/rev-b/13 Pack access panel.SLDPRT
cad/rev-b/14 Purchased M3 pack-cover spacer.SLDPRT
cad/rev-b/15 Electronics deck.SLDPRT
cad/rev-b/16 Purchased M4 deck spacer.SLDPRT
cad/rev-b/17 Purchased M3 PCB spacer.SLDPRT
cad/rev-b/18 Electronics side riser.SLDPRT
cad/rev-b/19 Front upper closure.SLDPRT
cad/rev-b/20 Electronics lid.SLDPRT
cad/rev-b/21 Electronics rear closure.SLDPRT
cad/rev-b/22 Silicone tread envelope.SLDPRT
cad/rev-b/23 Gearbox face doubler.SLDPRT
cad/rev-b/24 Clamp backing strip.SLDPRT
cad/rev-b/25 Floor hat stiffener.SLDPRT
cad/rev-b/26 Scoop formed underlay.SLDPRT
cad/rev-b/27 Side guard inboard return.SLDPRT
cad/rev-b/28 Rear bumper return.SLDPRT
cad/rev-b/McLaren 6WD - Rev B.SLDASM
cad/rev-b/McLaren 6WD - Rev B.STEP
cad/rev-b/REF ESP32 plus buck space.SLDPRT
cad/rev-b/REF LiPo 3S pack envelope.SLDPRT
cad/rev-b/REF Team IBT-2.SLDPRT
cad/rev-b/REF Team JGB37 motor.SLDPRT
cad/rev-b/REF Team rim 0.22.SLDPRT
cad/rev-c/01 Base plate.SLDPRT
cad/rev-c/02 Gearmotor face rail.SLDPRT
cad/rev-c/04 PETG motor clamp saddle.SLDPRT
cad/rev-c/05 PETG motor clamp cap.SLDPRT
cad/rev-c/06 Three-bend scoop skin.SLDPRT
cad/rev-c/07 Scoop support rib.SLDPRT
cad/rev-c/08 Scoop support foot.SLDPRT
cad/rev-c/09 Wheel side guard.SLDPRT
cad/rev-c/10 Guard angle.SLDPRT
cad/rev-c/11 Rear bumper wall.SLDPRT
cad/rev-c/12 Insulated pack tray.SLDPRT
cad/rev-c/13 Pack access panel.SLDPRT
cad/rev-c/14 Purchased M3 pack-cover spacer.SLDPRT
cad/rev-c/15 Electronics deck.SLDPRT
cad/rev-c/16 Purchased M4 deck spacer.SLDPRT
cad/rev-c/17 Purchased M3 PCB spacer.SLDPRT
cad/rev-c/18 Electronics side riser.SLDPRT
cad/rev-c/19 Front upper closure.SLDPRT
cad/rev-c/20 Electronics lid.SLDPRT
cad/rev-c/21 Electronics rear closure.SLDPRT
cad/rev-c/22 Silicone tread envelope.SLDPRT
cad/rev-c/23 Gearbox face doubler.SLDPRT
cad/rev-c/24 Clamp backing strip.SLDPRT
cad/rev-c/25 Floor hat stiffener.SLDPRT
cad/rev-c/26 Scoop formed underlay.SLDPRT
cad/rev-c/27 Side guard inboard return.SLDPRT
cad/rev-c/28 Rear bumper return.SLDPRT
cad/rev-c/29 REF M3x5 face screw and washer.SLDPRT
cad/rev-c/30 REF M4x40 clamp bolt.SLDPRT
cad/rev-c/31 REF M4 locknut and washer.SLDPRT
cad/rev-c/McLaren 6WD - Rev C.SLDASM
cad/rev-c/Print STL/04 PETG motor clamp saddle.STL
cad/rev-c/Print STL/05 PETG motor clamp cap.STL
cad/rev-c/REF ESP32 plus buck space.SLDPRT
cad/rev-c/REF LiPo 3S pack envelope.SLDPRT
cad/rev-c/REF Team IBT-2.SLDPRT
cad/rev-c/REF Team JGB37 motor.SLDPRT
cad/rev-c/REF Team rim 0.22.SLDPRT
cad/rev-d-workshop/SolidWorks/29 REF M3x5 face screw and washer.SLDPRT
cad/rev-d-workshop/SolidWorks/31 REF M4 locknut and washer.SLDPRT
cad/rev-d-workshop/SolidWorks/32 Shaheer V2 holder - chassis fit.SLDPRT
cad/rev-d-workshop/SolidWorks/33 REF M4x20 low-head floor bolt.SLDPRT
cad/rev-d-workshop/SolidWorks/34 REF M4x20 jaw bolt and 2 mm spacer.SLDPRT
cad/rev-d-workshop/SolidWorks/35 REF M4 narrow washer and locknut.SLDPRT
