MuhammadIsmail0331/mclaren-6wd-sumobot/(commit log)

2026-11-06 Add Rev B chassis and PETG motor clamp CAD
    [01 Base plate.SLDPRT, 02 Gearmotor face rail.SLDPRT, 03 Motor rail return strip.SLDPRT, 04 PETG motor clamp saddle.SLDPRT, 05 PETG motor clamp cap.SLDPRT, 06 Three-bend scoop skin.SLDPRT, 07 Scoop support rib.SLDPRT, 08 Scoop support foot.SLDPRT]
2026-11-06 Archive Rev A SolidWorks parts and assembled STEP
    [01 Base plate.SLDPRT, 02 Gearmotor face rail.SLDPRT, 03 Motor rail weld-on flange.SLDPRT, 04 Rear motor cradle.SLDPRT, 05 Motor keeper strap envelope.SLDPRT, 06 Formed three-bend scoop.SLDPRT, 07 Scoop support rib.SLDPRT, 08 Scoop support foot.SLDPRT]
2026-11-09 Publish Rev C motor mounts, hardware and manufacturing exports
    [01 Base plate.SLDPRT, 01 Base plate.dxf, 02 Gearmotor face rail.SLDPRT, 02 Gearmotor face rail.STEP, 02 Gearmotor face rail.dxf, 03 Motor rail return strip.SLDPRT, 03 Motor rail return strip.dxf, 04 PETG motor clamp saddle.SLDPRT]
2026-11-09 Add verified Rev D workshop assembly and pilot handoff
    [01 Base plate.SLDPRT, 01 Base plate.dxf, 01 PRINT ONE - 32 Shaheer V2 holder - chassis fit.stl, 02 GAUGE BATTERY FIRST - 12 Insulated pack tray.STL, 02 Gearmotor face rail - transfer drill.dxf, 02 Gearmotor face rail.SLDPRT, 03 GAUGE BOARDS FIRST - 15 Electronics deck.STL, 03 Wide motor rail return - shop review.dxf]
